Timocaf/Projet-Arduino/README.md

# Projet-Arduino : Polybanque
Trieur et distributeur automatisé à pieces avec connexion Bluetooth.

Martini Alexis - Pantani Timothé  Peip2-G3
