Timocaf/Projet-Arduino/Rapports de séance/Alexis MARTINI/Rapport 4 Martini Alexis G3.pdf

Rapport 4 Martini Alexis G3

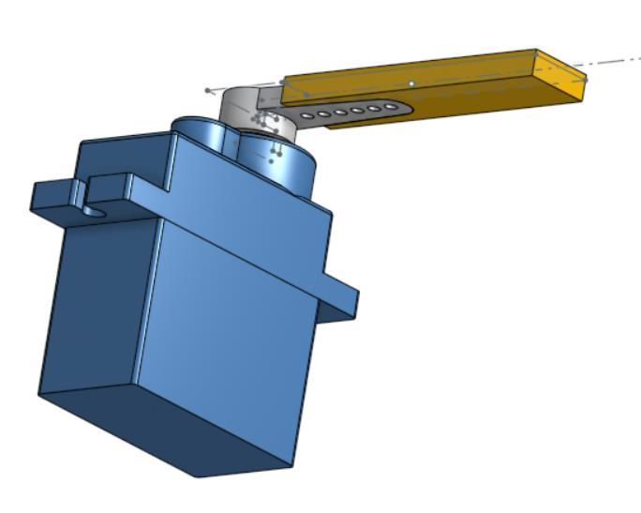
[picture p33: figure]

Durant cette séance j’ai commencé par régler divers problèmes. Par exemple dans la modélisation j’ai dû ajuster des mesures pour les servos et leurs pales (qui sont faites surmesure en 3D) car il y a deux générations de servo sg90. Les dimensions ont légèrement changé.

Aussi nous nous sommes rendu compte que nous n’avions pas assez de ports dans une Arduino uno. Plusieurs possibilités se sont offertes à nous. Nous avons fait le choix d’utiliser deux cartes Arduino en simultané. Pour cela il faut prévoir de les alimenter correctement ainsi que de créer une communication entre les deux cartes Arduino Uno en I2C.

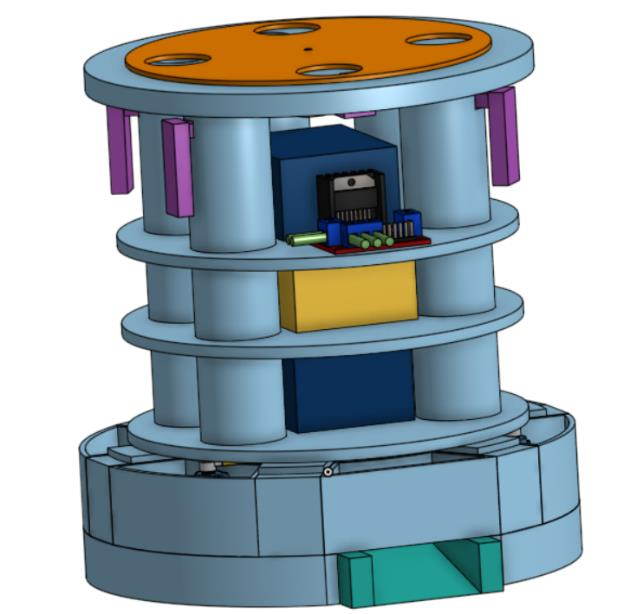
[picture p34: figure]

J’ai commencé à voir et comprendre comment cela
fonctionne. Il fallait aussi prévoir la place de placer
une carte Arduino uno en plus dans la modélisation.

Les cartes Arduino sont modélisées par les blocs bleus. En jaune il s’agit du board.

Nous avons également mis à jour l’interface sur le téléphone. Il y a dorénavant un bouton qui sert à afficher le montant présent dans la machine. Aussi le texte défile vers le haut.

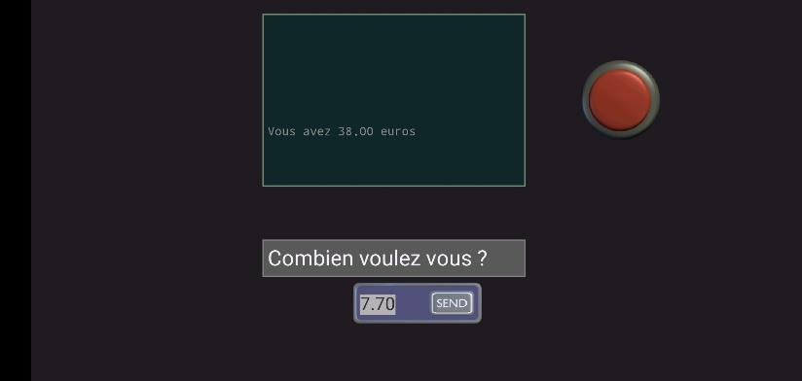
[picture p35: figure]

Précédemment nous avions eu un problème. Lorsque l’on envoie un message de la carte Bluetooth au téléphone les servo-moteurs bougeaient légèrement. Cela nous embêtait et on nous a expliqué que cela venait du fait que la carte Arduino ne possédait que deux horloges. Demander à une carte de faire fonctionner le Bluetooth et les servos peut donc créer des interférences et des problèmes.

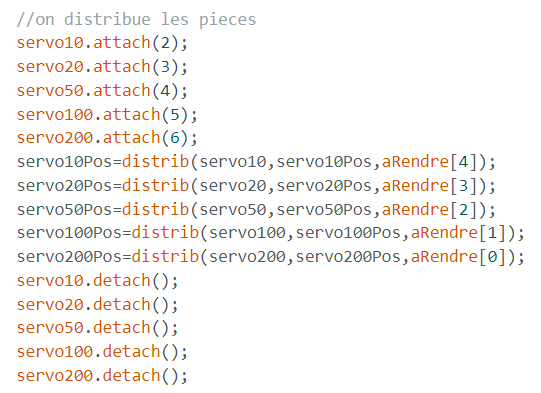
[picture p36: figure]

Pour régler cela, dans les programmes après avoir fait fonctionner un moteur on le détache d’un PIN afin que la carte ne puisse pas
communiquer avec sans faire exprès.

En fin de séance nous avons fait une présentation orale de notre projet à nos professeurs. Ils nous ont dit qu’il fallait commencer à concevoir notre objet et d’imprimer des pièces. Ce que nous avons donc fais-en fin de cours, nous avons lancé la fabrication de nos tubes de pièces.
