Timocaf/Projet-Arduino/Rapports de séance/Timothé PANTANI/Rapport_Séance_3.pdf

### Séance du 08/01/2024 Planning : Mise en place du système de redistribution

Durant cette séance, mon rôle était de câbler et testé notre algorithme de redistribution des pièces et d’apprendre à bien utiliser les Servo moteurs. Tout cela dans le but d’être prêt à monter une
maquette pour la séance 4. La partie code a été faite par Alexis durant les vacances.

Voici le code :

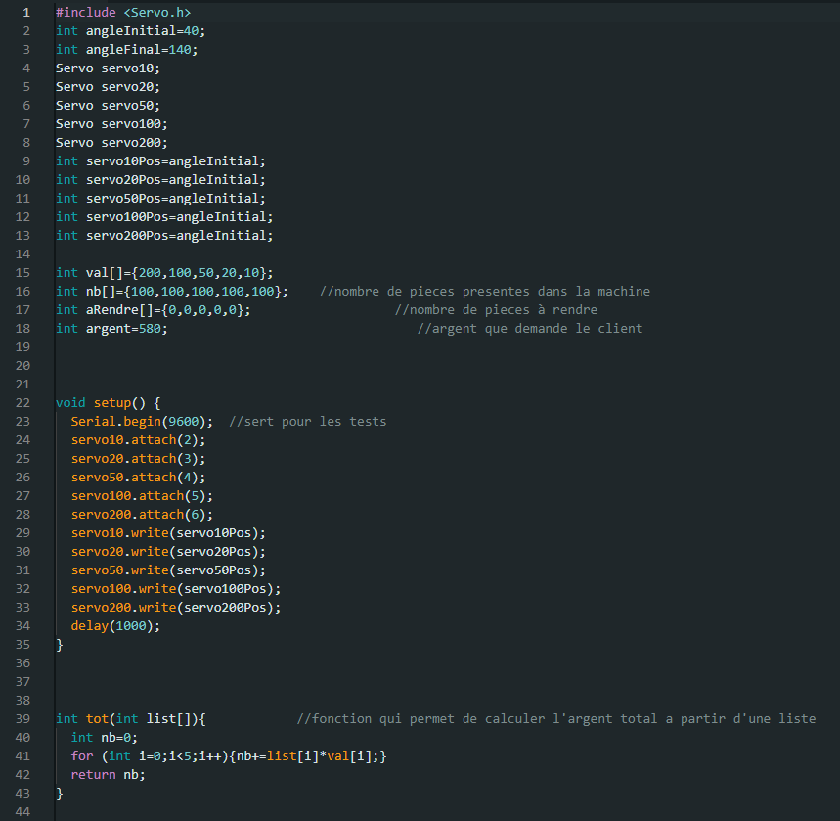
[picture p40: figure]
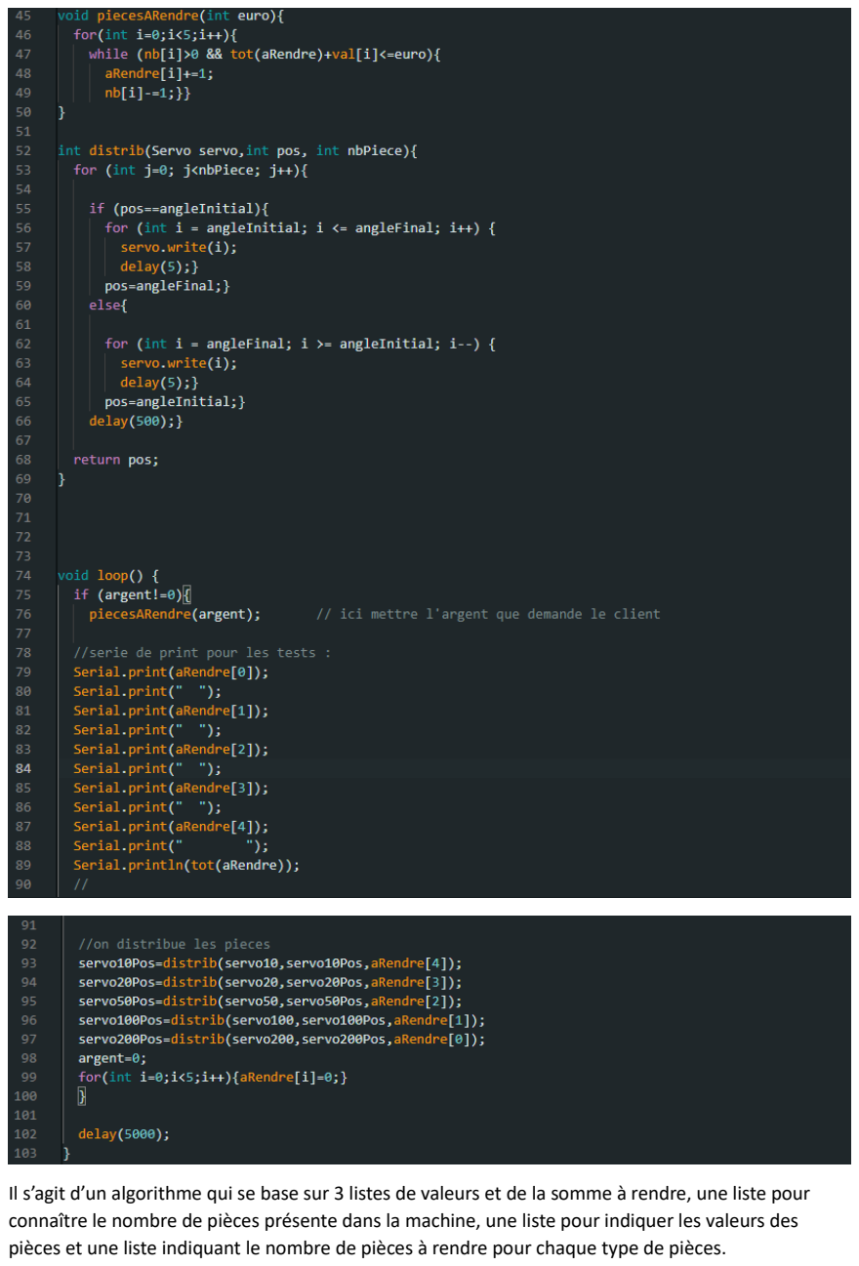
[picture p41: page 2]

Il s’agit d’un algorithme qui se base sur 3 listes de valeurs et de la somme à rendre, une liste pour connaître le nombre de pièces présente dans la machine, une liste pour indiquer les valeurs des pièces et une liste indiquant le nombre de pièces à rendre pour chaque type de pièces.

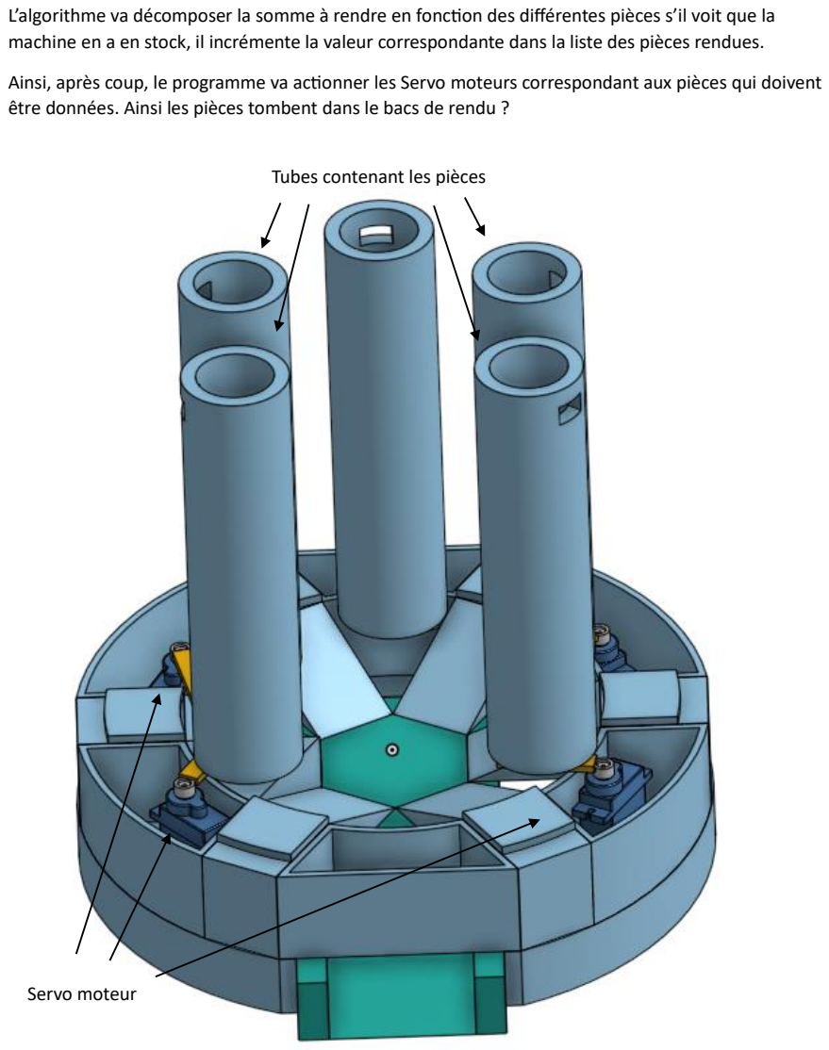
[picture p42: page 3]

L’algorithme va décomposer la somme à rendre en fonction des différentes pièces s’il voit que la machine en a en stock, il incrémente la valeur correspondante dans la liste des pièces rendues.

Ainsi, après coup, le programme va actionner les Servo moteurs correspondant aux pièces qui doivent être données. Ainsi les pièces tombent dans le bacs de rendu ?

Servo moteur

Tubes contenant les pièces

Et donc voici le montage :

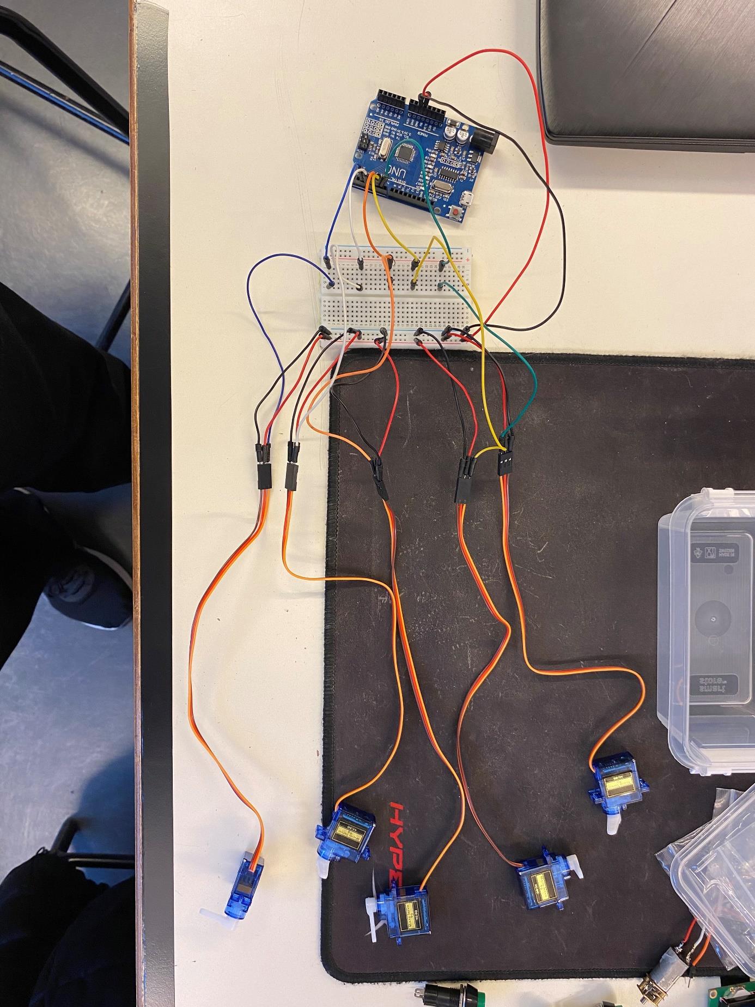
[picture p43: figure]

En fonctionnement : https://youtube.com/shorts/racFUhVq_IU?feature=shared

Alexis ayant fait de son côté la communication Bluetooth, il reste l’implémentation des boutons et de l’écran LCD et de tout assembler sur une maquette avant de produire la version finale. L’assemblement du code ne semble pour l’instant pas si complexe mais un problème risque de surgir, nous risquons de ne pas avoir assez de ports d’entrées-sorties sur notre carte Arduino Uno.
