Timocaf/Projet-Arduino/Presentation_Polybanque.pdf

# POLYBANQUE

Martini Alexis et Pantani Timothé Peip2 G3

# Objectifs du projet

- collecter et trier les pièces
- compter les pièces
- afficher les informations
- distribuer les pièces par les boutons
- distribuer les pièces par connexion Bluetooth

08/03/2024

POLYBANQUE

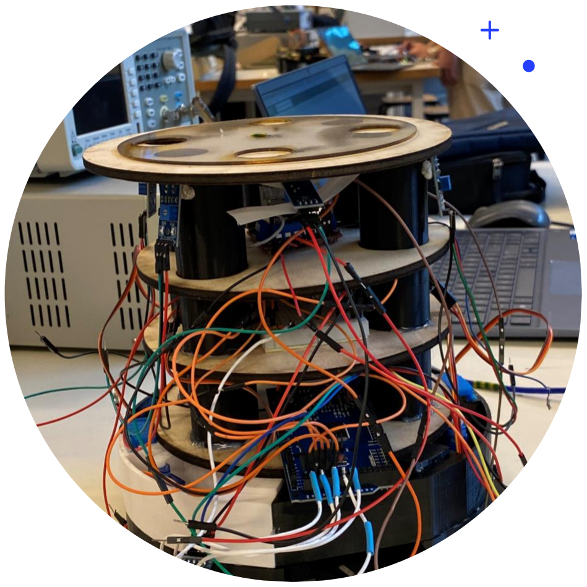
[picture p48: figure]

2

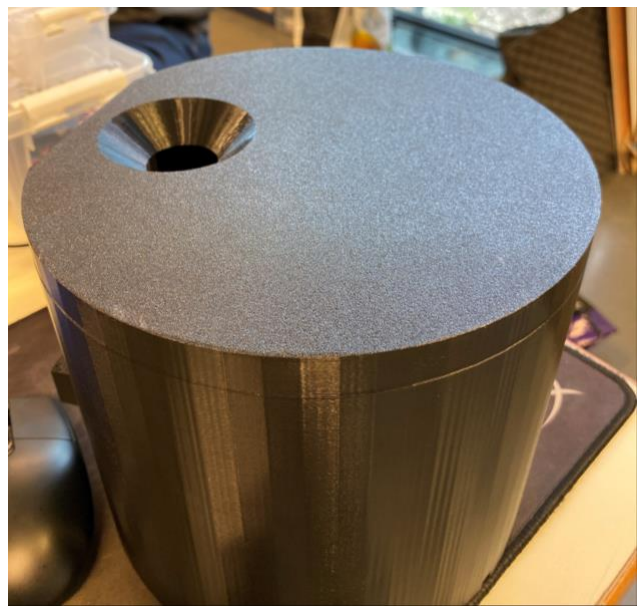
[picture p49: figure]
Mettre image des boutons ou du trou en haut

# Comment l’utiliser ?

- insertion et tri de pièces
- distribution manuelle
- distribution Bluetooth

POLYBANQUE


3

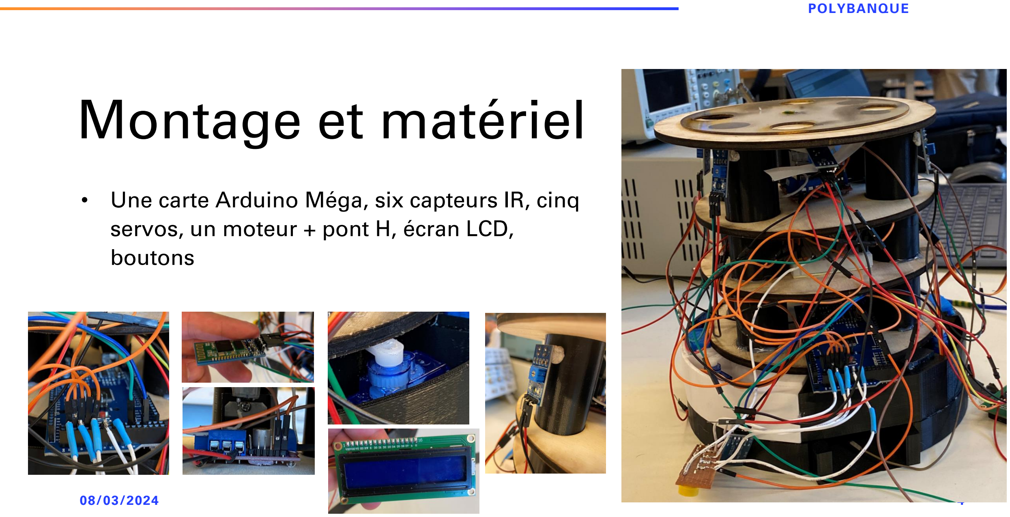
[picture p50: page 4]

# Montage et matériel

- Une carte Arduino Méga, six capteurs IR, cinq servos, un moteur + pont H, écran LCD, boutons

POLYBANQUE

4

# Fonctionnement

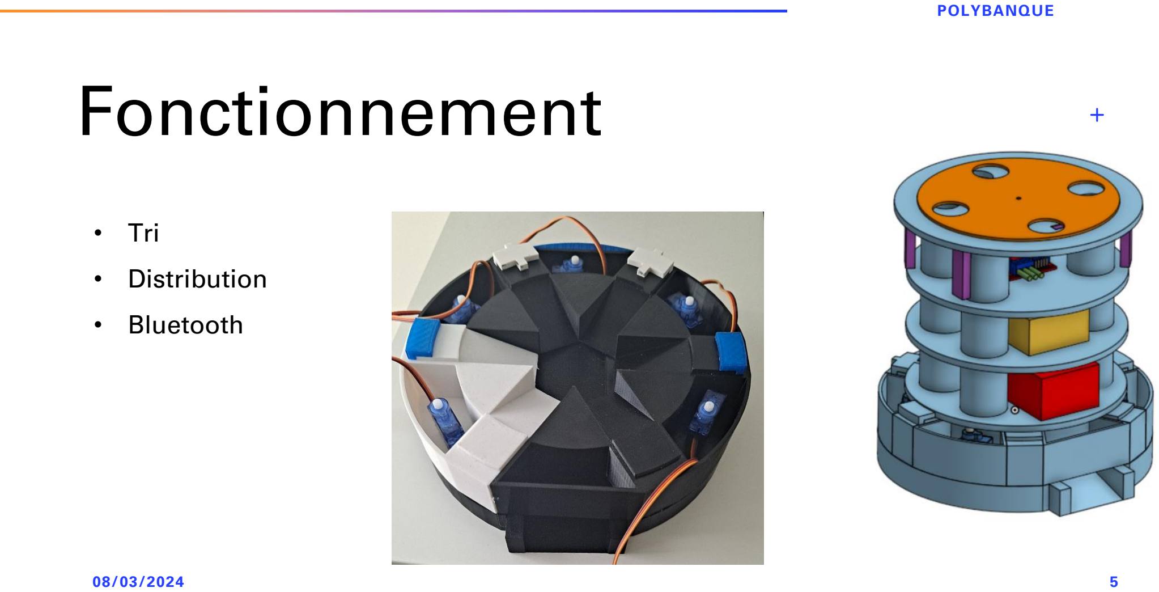
[picture p51: page 5]

- Tri
- Distribution
- Bluetooth

POLYBANQUE

5

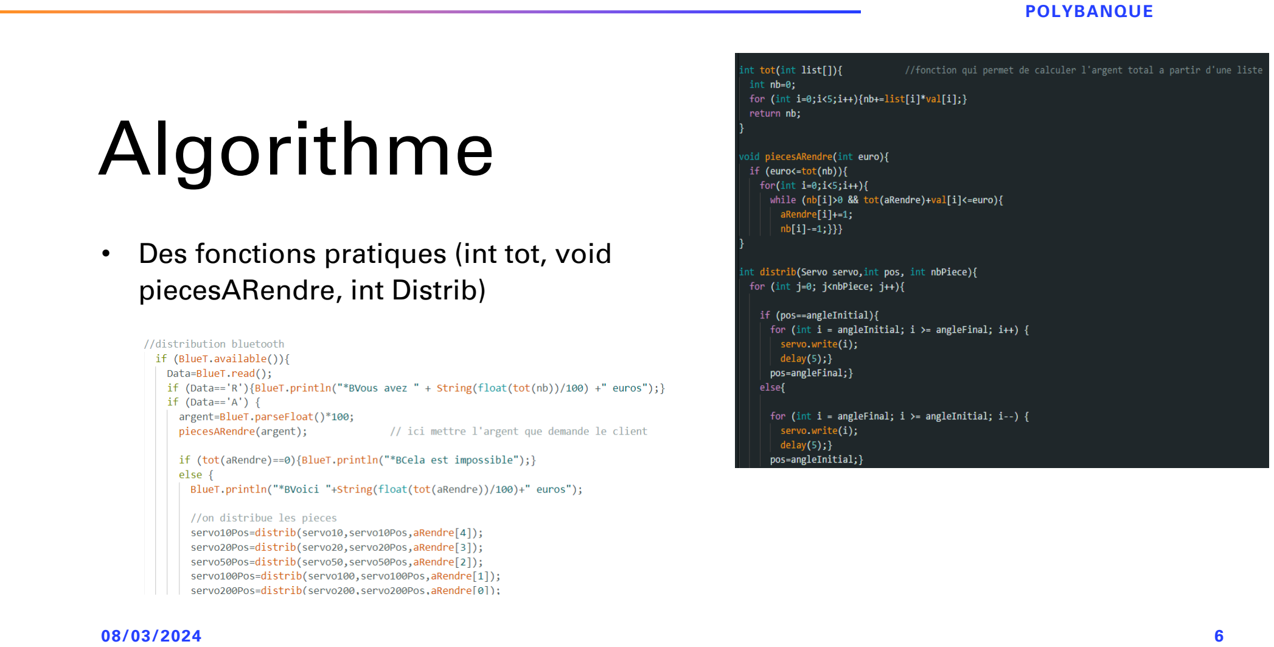
[picture p52: page 6]

# Algorithme

- Des fonctions pratiques (int tot, void piecesARendre, int Distrib)

POLYBANQUE

6

# Problèmes rencontrés

- Compatibilité des modules
- Matériel
- Logistique
- Assemblage

POLYBANQUE

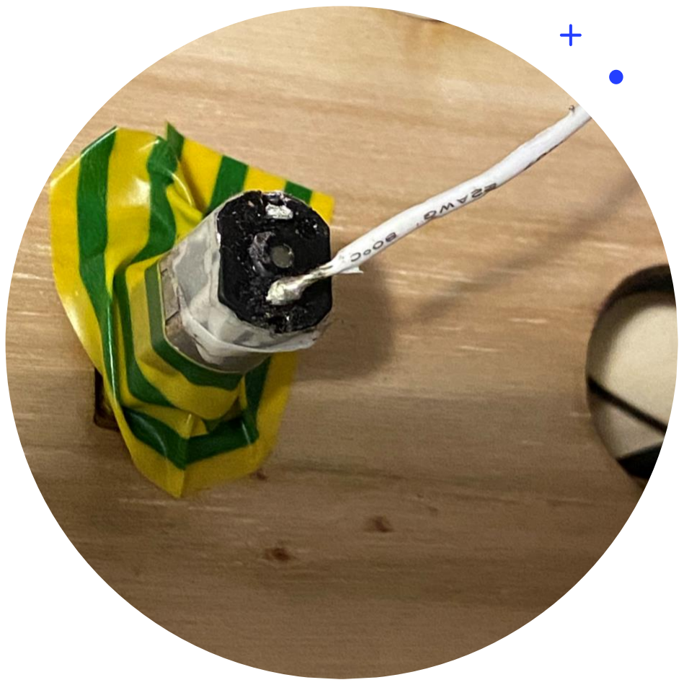
[picture p53: figure]

7

# POLYBANQUE

# Merci de votre écoute
