Timocaf/Projet-Arduino/Tutoriel_Bluetooth.pdf

## Tutoriel Bluetooth

Pour utiliser notre machine en connexion Bluetooth vous devez :


1- Installer l’application Bluetooth Electronics

2- créer un panel avec :

- Un monitor qui reçoit la lettre « B »
- Un bouton qui envoie la lettre « R »
- Un terminal Send qui commence avec « A »

3- vous connecter au Bluetooth avec la machine (code=2410) puis lancer le panel

4- profitez !


Pour rappel avec cela on peut envoyer un montant qui sera distribué par la machine et demander de voir le total d’argent présent en appuyant sur le bouton. Le monitor affiche les actions.
