Timocaf/Projet-Arduino/(commit log)

2023-12-08 Create Rapports de séance
2023-12-19 Create Ordre de conception du projet
2023-12-20 Update Ordre de conception du projet
